joaoarquimedes/hifiaudio_project/docs/subbass/esquema.png

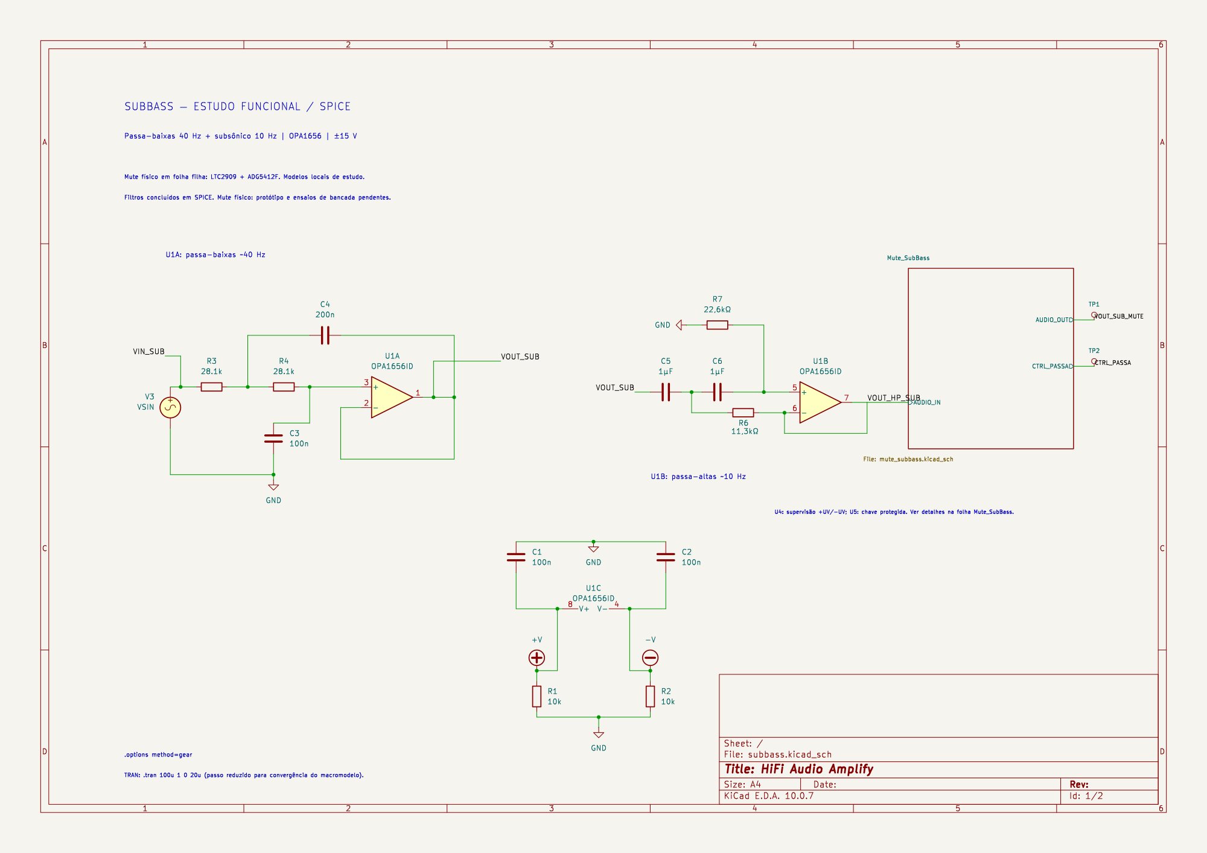
docs/subbass/esquema.png
