joaoarquimedes/hifiaudio_project/docs/subbass/falhas_trilhos.png

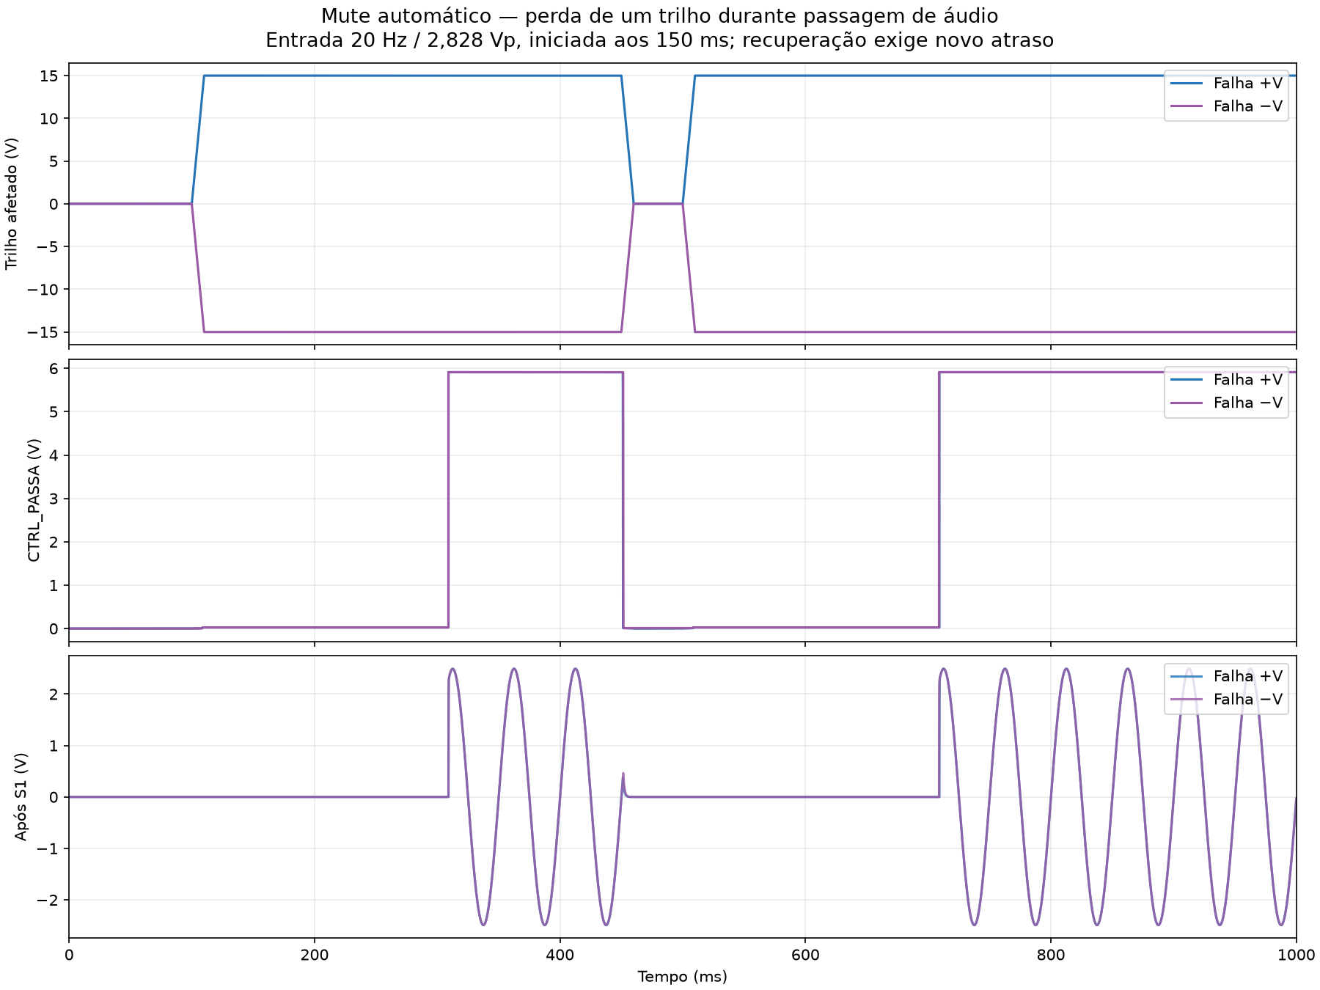
docs/subbass/falhas_trilhos.png
