joaoarquimedes/hifiaudio_project/docs/subbass/hardware/esquema_mute.png

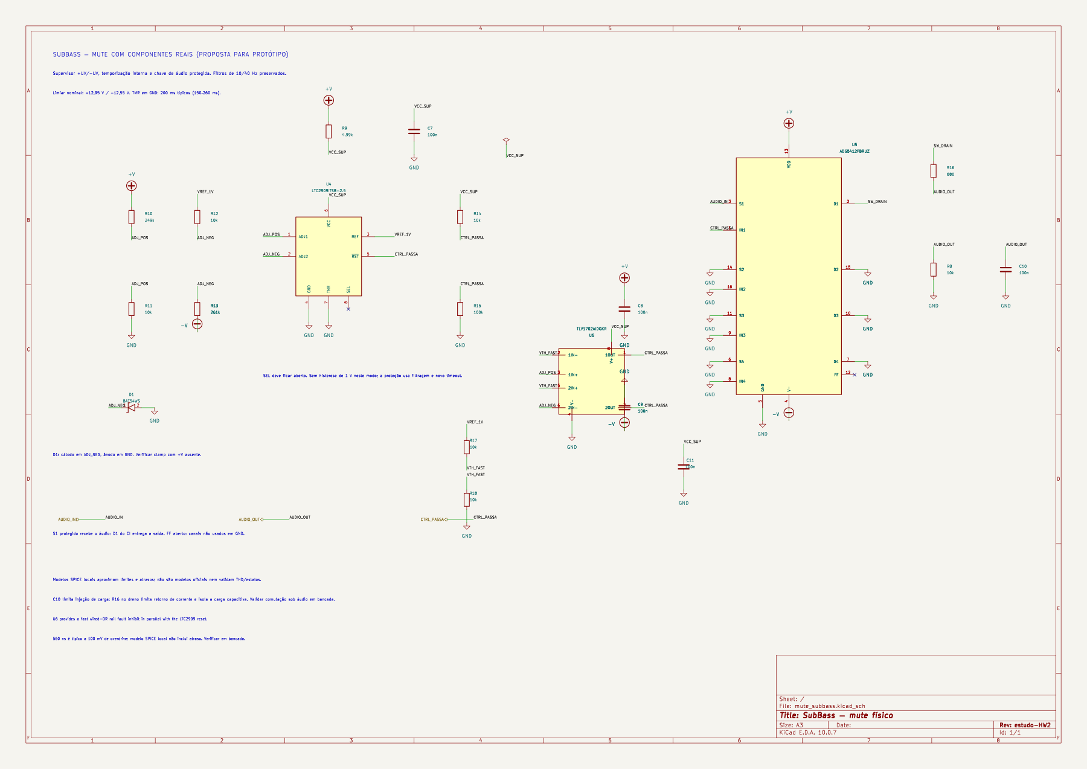
docs/subbass/hardware/esquema_mute.png
