joaoarquimedes/hifiaudio_project/docs/subbass/mute_automatico.png

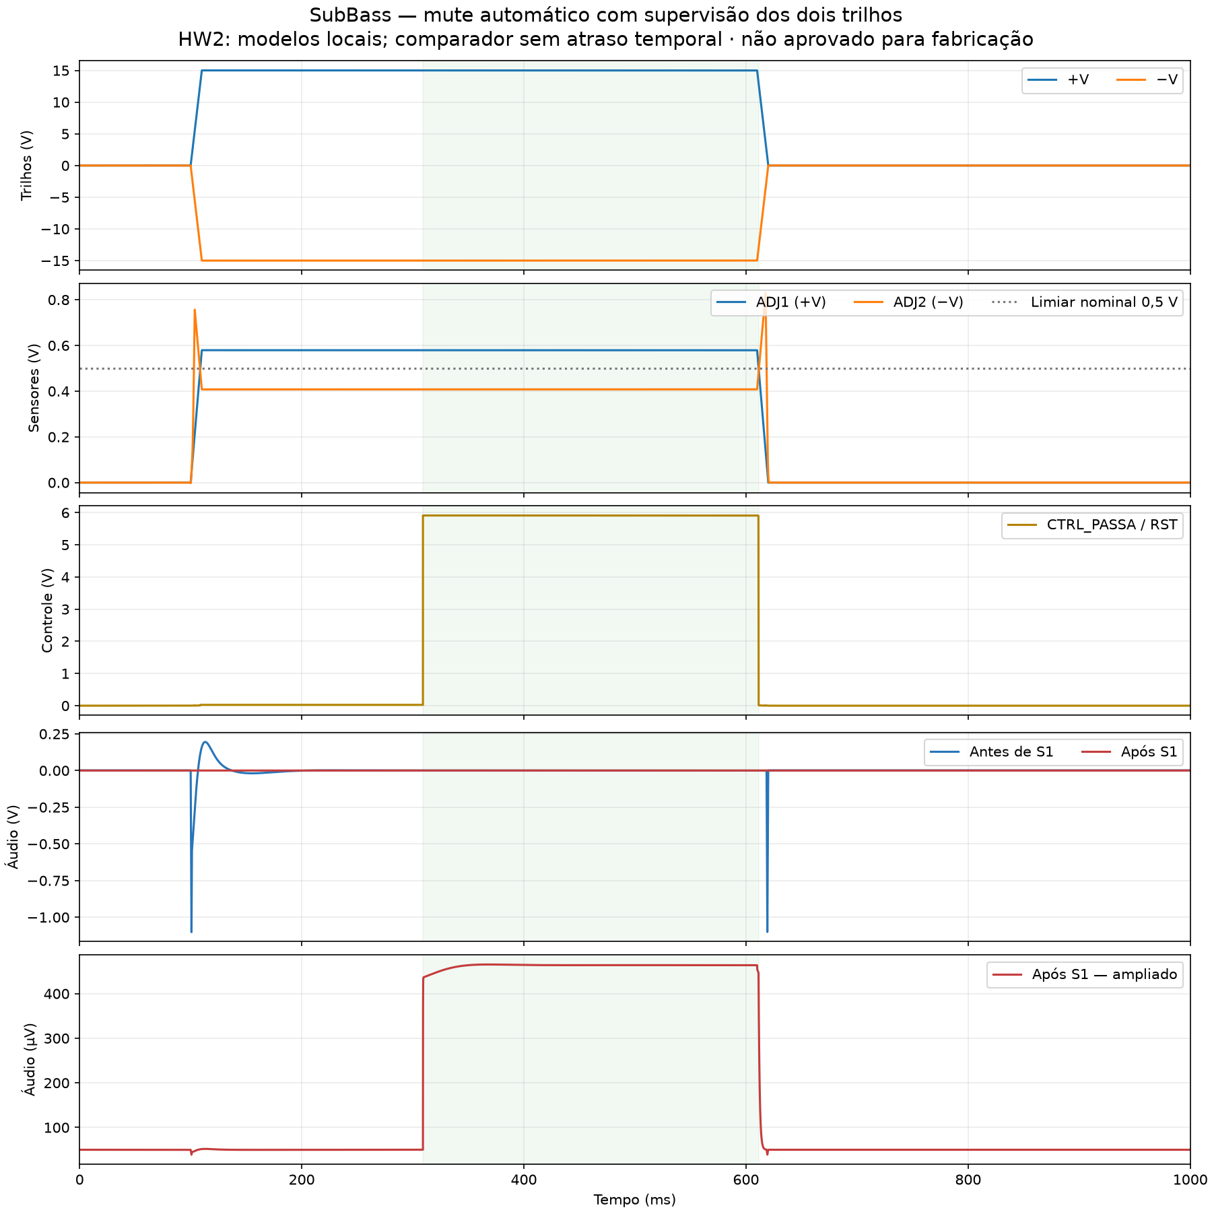
docs/subbass/mute_automatico.png
