joaoarquimedes/hifiaudio_project/docs/subbass/resposta_ac.png

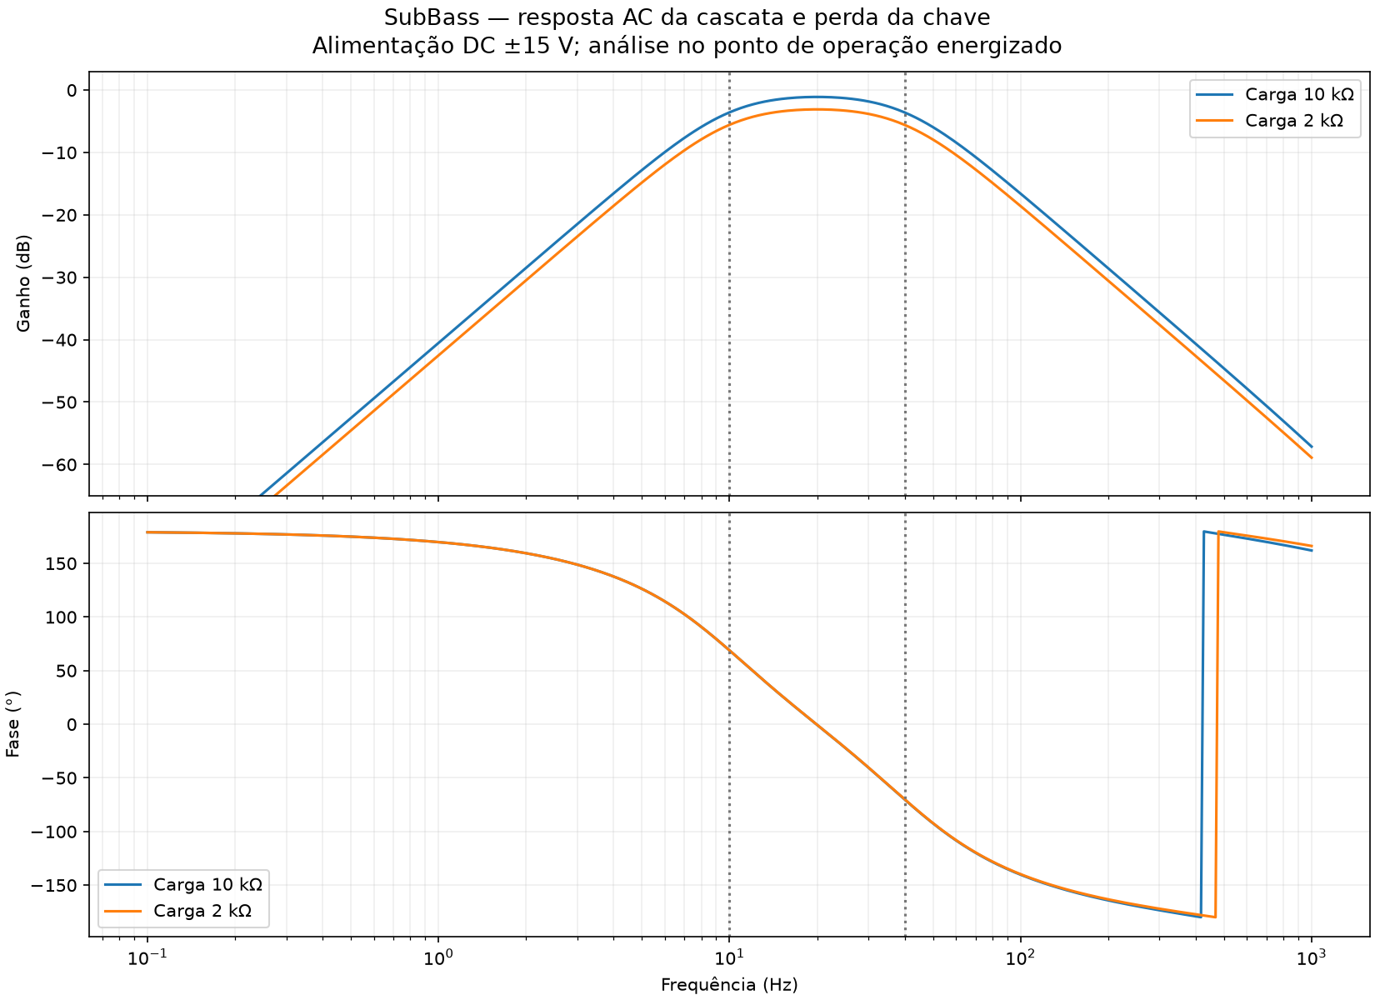
docs/subbass/resposta_ac.png
