joaoarquimedes/hifiaudio_project/(list of files, drawings)

Other design files:
spice/OPA1656/sbomaw6c/OPA1656.OLB
spice/OPA1656/sbomaw6c/OPA1656_Test_Circuit.DSN
spice/OPA1656/sbomaw6c/OPA1656_Test_Circuit.OPJ
