joaoarquimedes/hifiaudio_project/hifi_audio.kicad_pcb

## KiCad design hifi_audio.kicad_pcb (2026-10-16)

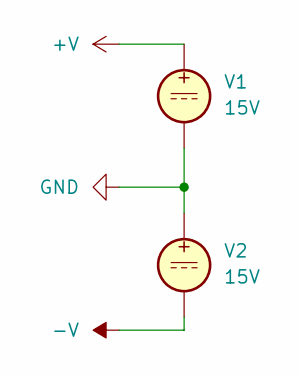
[picture p6: schematic Bancada_Simulacao.kicad_sch, HiFi Audio Amplify]

Parts:
V1, V2: 15V

Connections:
unnamed: V1.2, V2.1

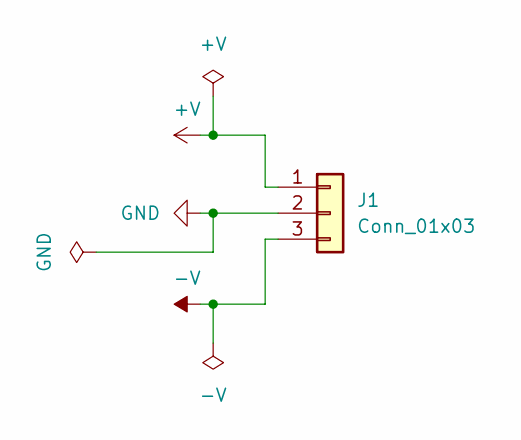
[picture p7: schematic fonte_alimentacao.kicad_sch, HiFi Audio Amplify]

Parts:
J1: Conn_01x03; JST_XH_B3B-XH-A_1x03_P2.50mm_Vertical

Connections:
+V: J1.1; also elsewhere on the board
-V: J1.3; also elsewhere on the board
GND: J1.2; also elsewhere on the board

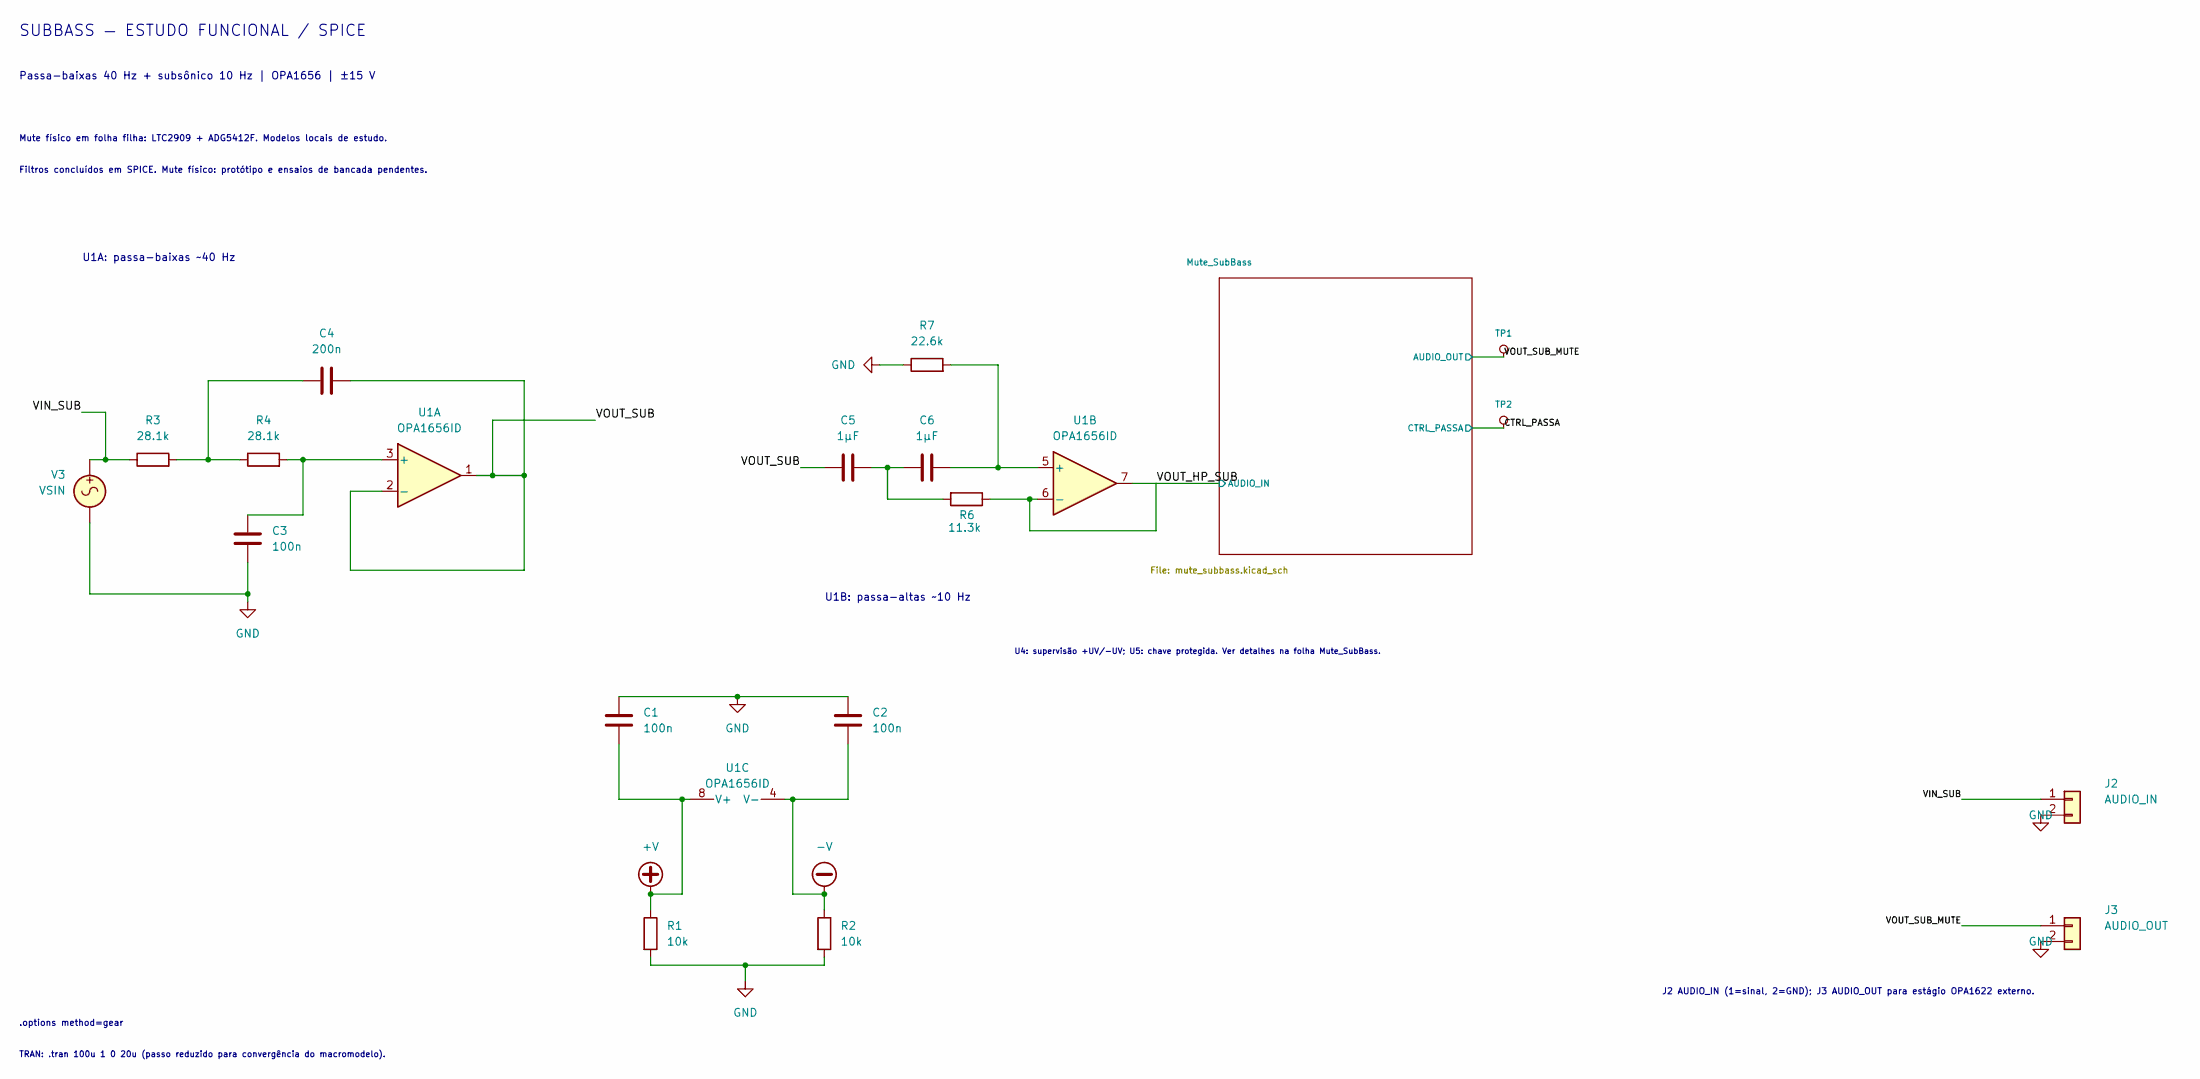
[picture p8: schematic subbass.kicad_sch, HiFi Audio Amplify]

Parts:
C1, C2, C3: 100n; C_0805_2012Metric
C4: 200n; C_0805_2012Metric
C5, C6: 1µF; C_1206_3216Metric
J2: AUDIO_IN; JST_XH_B2B-XH-A_1x02_P2.50mm_Vertical
J3: AUDIO_OUT; JST_XH_B2B-XH-A_1x02_P2.50mm_Vertical
R1, R2: 10k; R_0805_2012Metric
R3, R4: 28.1k; R_0805_2012Metric
R6: 11.3k; R_0805_2012Metric
R7: 22.6k; R_0805_2012Metric
TP1, TP2: TestPoint; TestPoint_Pad_D1.5mm
U1: OPA1656ID; SOIC-8_3.9x4.9mm_P1.27mm
V3: VSIN

Connections:
+V: C1.2, R1.1, U1.8 (V+); also elsewhere on the board
-V: C2.2, R2.1, U1.4 (V-); also elsewhere on the board
/subbass/CTRL_PASSA: TP2.1; also elsewhere on the board
/subbass/VIN_SUB: J2.1, R3.1, V3.1
/subbass/VOUT_HP_SUB: R6.1, U1.6 (-), U1.7; also elsewhere on the board
/subbass/VOUT_SUB: C4.2, C5.1, U1.1, U1.2 (-)
/subbass/VOUT_SUB_MUTE: J3.1, TP1.1; also elsewhere on the board
GND: C1.1, C2.1, C3.2, J2.2, J3.2, R1.2, R2.2, R7.1, V3.2; also elsewhere on the board
unnamed: C4.1, R3.2, R4.1
unnamed: C5.2, C6.1, R6.2
unnamed: C3.1, R4.2, U1.3 (+)
unnamed: C6.2, R7.2, U1.5 (+)

Notes on the sheet:
SUBBASS — ESTUDO FUNCIONAL / SPICE
Passa-baixas 40 Hz + subsônico 10 Hz | OPA1656 | ±15 V
U1A: passa-baixas ~40 Hz
U1B: passa-altas ~10 Hz
.options method=gear
TRAN: .tran 100u 1 0 20u (passo reduzido para convergência do macromodelo).
Mute físico em folha filha: LTC2909 + ADG5412F. Modelos locais de estudo.
Filtros concluídos em SPICE. Mute físico: protótipo e ensaios de bancada pendentes.
U4: supervisão +UV/-UV; U5: chave protegida. Ver detalhes na folha Mute_SubBass.
J2 AUDIO_IN (1=sinal, 2=GND); J3 AUDIO_OUT para estágio OPA1622 externo.

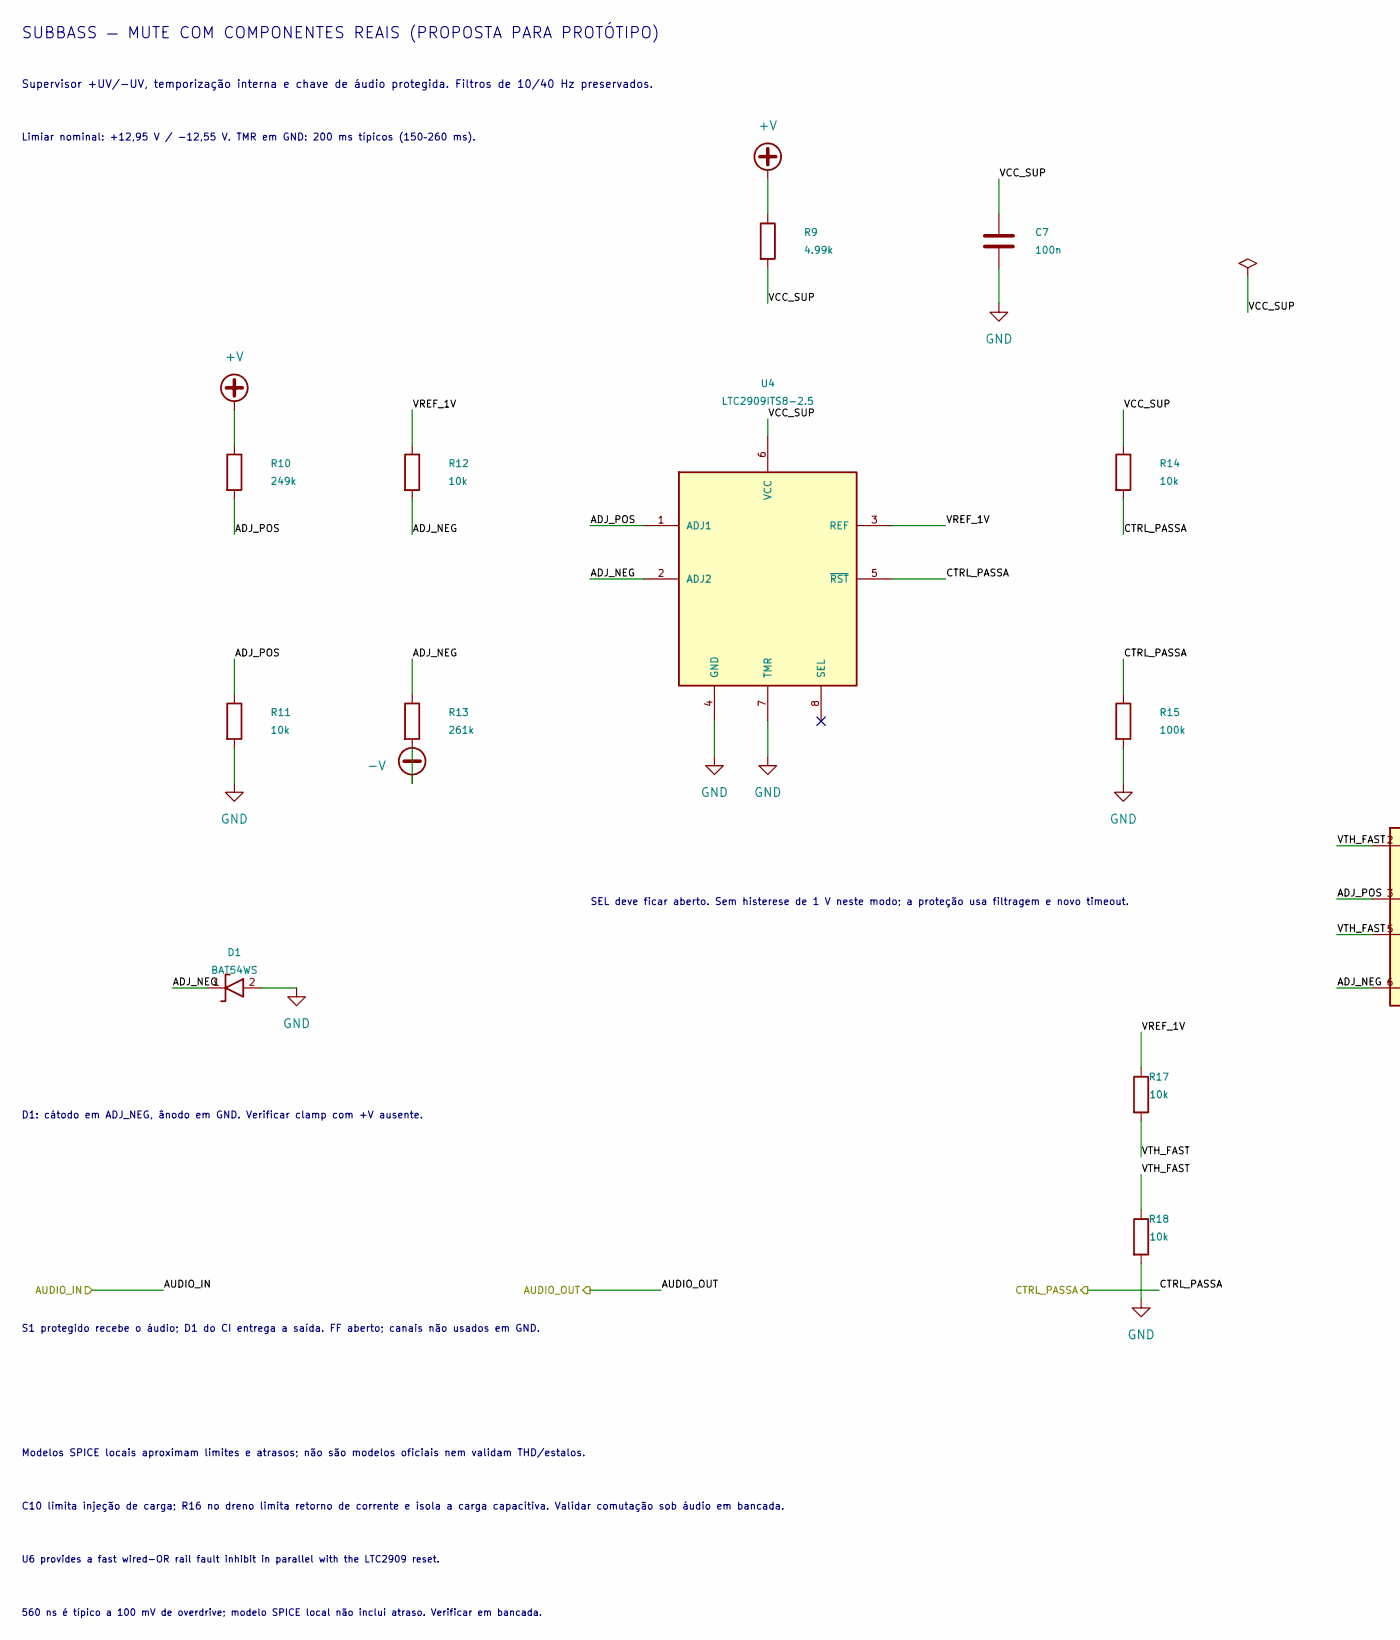
[picture p9: schematic mute_subbass.kicad_sch, SubBass — mute físico, part in row 1, column 1]

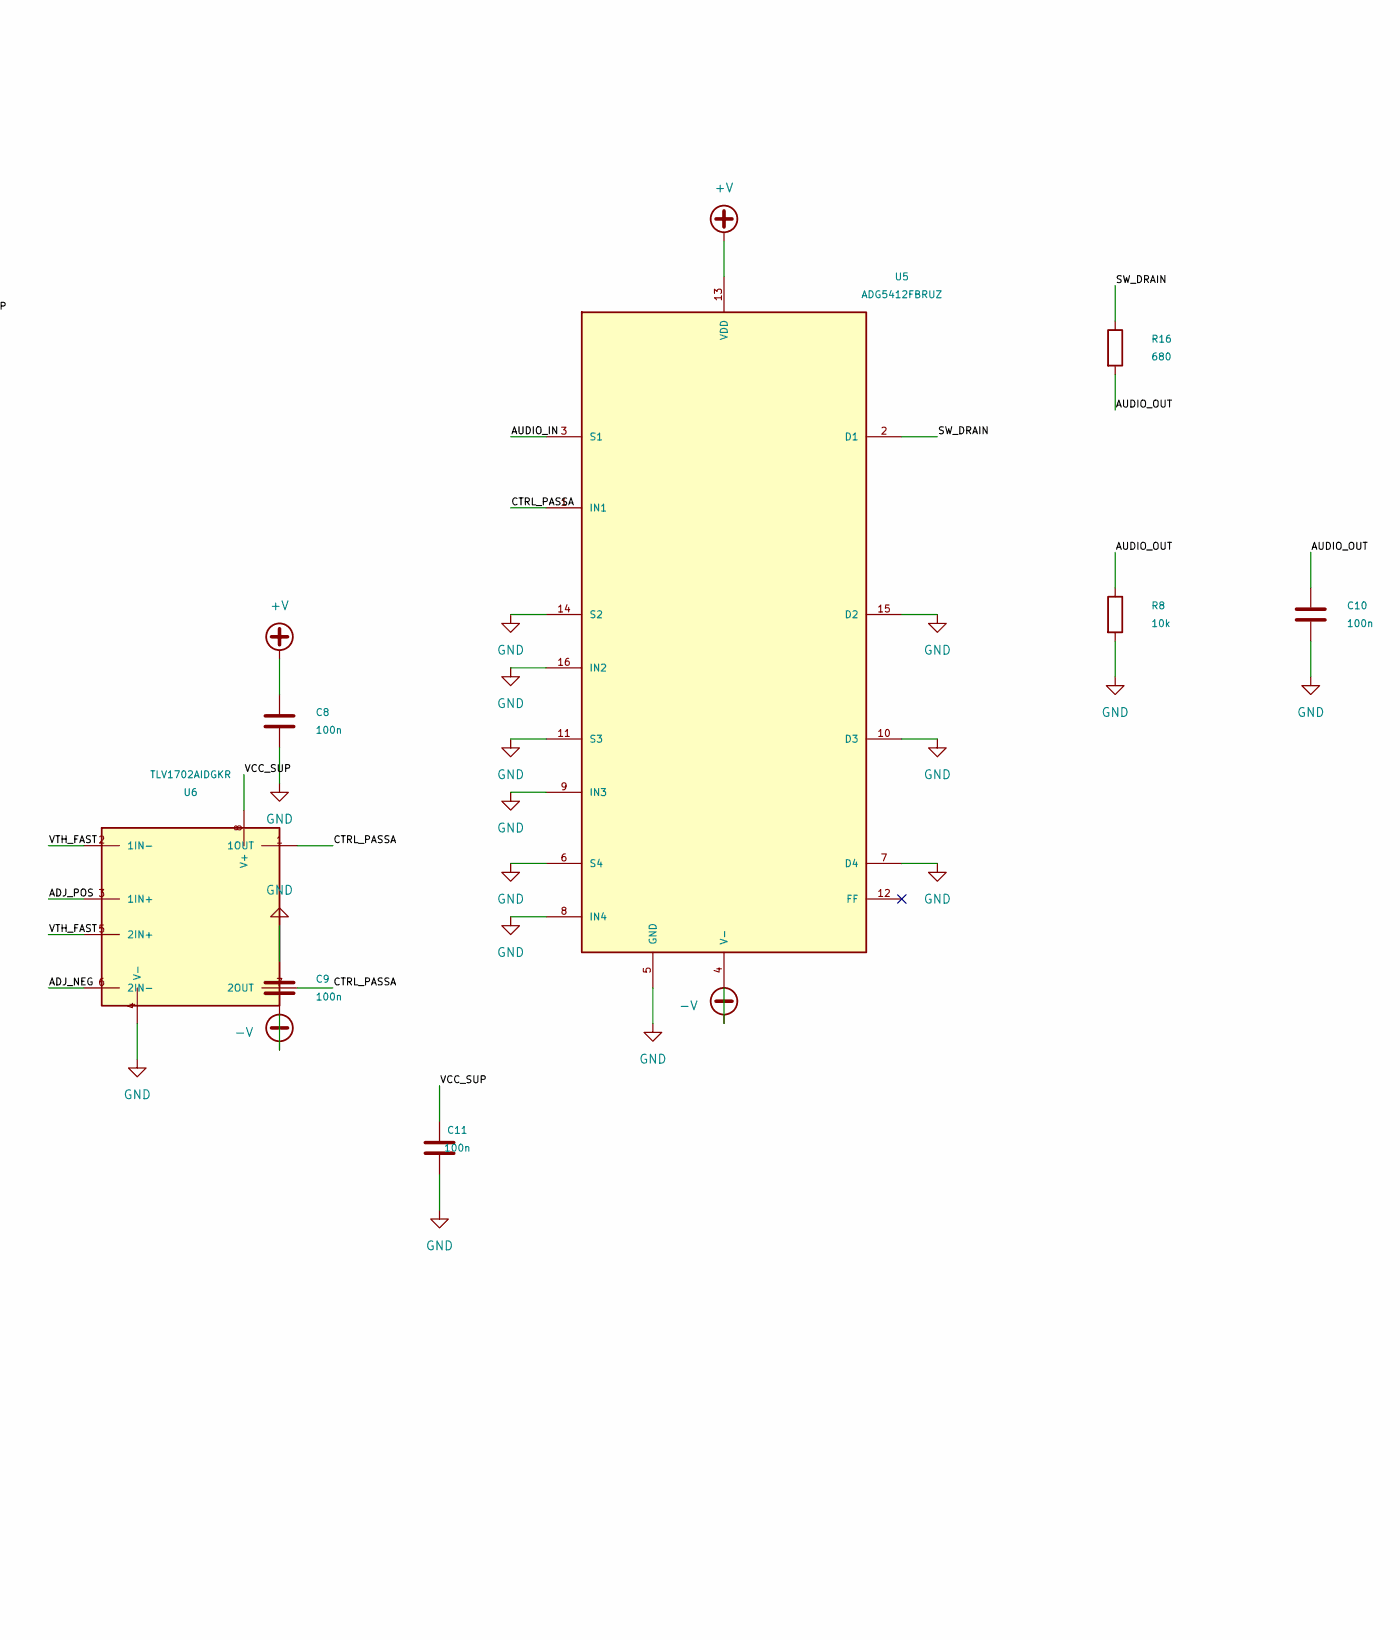
[picture p10: schematic mute_subbass.kicad_sch, SubBass — mute físico, part in row 1, column 2]

Parts:
C7, C8, C9: 100n; C_0805_2012Metric; Voltage 50V; Tolerance 10%
C10: 100n; C_1206_3216Metric; Voltage 50V; Tolerance 5%
C11: 100n; C_0805_2012Metric; Voltage 50V; MPN GRM21BR71H104KA01L
D1: BAT54WS; D_SOD-323; MPN BAT54WS-7-F
R8, R14: 10k; R_0805_2012Metric; Tolerance 1%
R9: 4.99k; R_0805_2012Metric; Tolerance 0.1%
R10: 249k; R_0805_2012Metric; Tolerance 0.1%
R11, R12: 10k; R_0805_2012Metric; Tolerance 0.1%
R13: 261k; R_0805_2012Metric; Tolerance 0.1%
R15: 100k; R_0805_2012Metric; Tolerance 1%
R16: 680; R_1206_3216Metric; Tolerance 1%
R17, R18: 10k; R_0805_2012Metric; Tolerance 1%; MPN CRCW080510K0FKEA
U4: LTC2909ITS8-2.5; SOT-23-8; MPN LTC2909ITS8-2.5#TRMPBF
U5: ADG5412FBRUZ; TSSOP-16_4.4x5mm_P0.65mm; MPN ADG5412FBRUZ
U6: TLV1702AIDGKR; VSSOP-8_2.3x2mm_P0.5mm; MPN TLV1702AIDGKR

Connections:
+V: C8.1, R9.1, R10.1, U5.13 (VDD); also elsewhere on the board
-V: C9.2, R13.2, U5.4 (V-); also elsewhere on the board
/subbass/CTRL_PASSA: R14.2, R15.1, U4.5 (~RST), U5.1 (IN1), U6.1 (1OUT), U6.7 (2OUT); also elsewhere on the board
/subbass/Mute_SubBass/ADJ_NEG: D1.1 (K), R12.2, R13.1, U4.2 (ADJ2), U6.6 (2IN-)
/subbass/Mute_SubBass/ADJ_POS: R10.2, R11.1, U4.1 (ADJ1), U6.3 (1IN+)
/subbass/Mute_SubBass/SW_DRAIN: R16.1, U5.2 (D1)
/subbass/Mute_SubBass/VCC_SUP: C7.1, C11.1, R9.2, R14.1, U4.6 (VCC), U6.8 (V+)
/subbass/Mute_SubBass/VREF_1V: R12.1, R17.1, U4.3 (REF)
/subbass/Mute_SubBass/VTH_FAST: R17.2, R18.1, U6.2 (1IN-), U6.5 (2IN+)
/subbass/VOUT_HP_SUB: U5.3 (S1); also elsewhere on the board
/subbass/VOUT_SUB_MUTE: C10.1, R8.1, R16.2; also elsewhere on the board
GND: C7.2, C8.2, C9.1, C10.2, C11.2, D1.2 (A), R8.2, R11.2, R15.2, R18.2, U4.4 (GND), U4.7 (TMR), U5.5 (GND), U5.6 (S4), U5.7 (D4), U5.8 (IN4), U5.9 (IN3), U5.10 (D3), U5.11 (S3), U5.14 (S2), U5.15 (D2), U5.16 (IN2), U6.4 (V-); also elsewhere on the board

Notes on the sheet:
SUBBASS — MUTE COM COMPONENTES REAIS (PROPOSTA PARA PROTÓTIPO)
Supervisor +UV/-UV, temporização interna e chave de áudio protegida. Filtros de 10/40 Hz preservados.
Limiar nominal: +12,95 V / −12,55 V. TMR em GND: 200 ms típicos (150–260 ms).
SEL deve ficar aberto. Sem histerese de 1 V neste modo; a proteção usa filtragem e novo timeout.
D1: cátodo em ADJ_NEG, ânodo em GND. Verificar clamp com +V ausente.
S1 protegido recebe o áudio; D1 do CI entrega a saída. FF aberto; canais não usados em GND.
Modelos SPICE locais aproximam limites e atrasos; não são modelos oficiais nem validam THD/estalos.
C10 limita injeção de carga; R16 no dreno limita retorno de corrente e isola a carga capacitiva. Validar comutação sob áudio em bancada.
U6 provides a fast wired-OR rail fault inhibit in parallel with the LTC2909 reset.
560 ns é típico a 100 mV de overdrive; modelo SPICE local não inclui atraso. Verificar em bancada.

Board: 2 copper layers, 42 parts (0 on the bottom side), 18 nets, no tracks yet.

Other parts of the board:
MH1, MH2, MH3, MH4: MountingHole_3.2mm_M3
