joaoarquimedes/hifiaudio_project/(commit log)

2026-10-15 Definicao subbass e filtro passa baixo
    [Bancada_Simulacao.kicad_sch, fonte_alimentacao.kicad_sch, hifi_audio.kicad_sch, subbass.kicad_sch]
2026-10-15 preparando fase subsonica
    [subbass.kicad_sch]
2026-10-16 Valida cascata subbass 40 Hz e subsonico 10 Hz em ±15 V
    [Bancada_Simulacao.kicad_sch, fonte_alimentacao.kicad_sch, subbass.kicad_sch]
2026-10-16 Conclui ensaios de degrau e sequenciamento da alimentacao do subbass
    [Bancada_Simulacao.kicad_sch, subbass.kicad_sch]
2026-10-16 Add SubBass mute control and verification scripts
    - Introduced a new SPICE subcircuit for SubBass mute control, implementing a dual-rail supervisor with diagnostic outputs.
    - Created a symbol library for Hi-Fi audio components in KiCad.
    - Added a Python script to plot results from SubBass simulations, visualizing startup, shutdown, and AC response.
    - Developed a verification script for the SubBass design, exporting netlists and validating functionality through simulation with ngspice.
    [Bancada_Simulacao.kicad_sch, subbass.kicad_sch]
2026-10-16 Finalize SubBass mute hardware proposal
    [bom_mute.csv, mute_subbass.kicad_sch, subbass.kicad_sch]
2026-10-16 Refactor SubBass hardware and verification scripts for HW2 mute proposal
    - Added TLV1702 fast fault path model to subbass_hardware.lib for improved fault detection.
    - Updated plot_subbass.py title and descriptions to reflect changes in hardware proposal from HW1 to HW2.
    - Modified verify_subbass.py to validate the new HW2 mute proposal, including adjustments to expected cutoff timing and report details.
    - Enhanced test cases for fault detection and recovery scenarios to ensure robustness with new hardware configurations.
    [bom_mute.csv, mute_subbass.kicad_sch]
2026-10-16 Refactor SubBass project: Update track widths, add new connector symbols, and document modular architecture
    - Reduced minimum track width and clearance in hifi_audio.kicad_pro for improved routing.
    - Added new connector symbols for AUDIO_IN and AUDIO_OUT in subsbass.kicad_sch.
    - Updated footprints for various components in subsbass.kicad_sch to ensure compatibility.
    - Introduced modular architecture documentation in arquitetura_modular.md outlining the design and electrical interfaces.
    - Created build_subbass_module_board.py script to automate PCB placement from schematic netlist.
    [fonte_alimentacao.kicad_sch, hifi_audio.kicad_pcb, subbass.kicad_sch]
2026-10-16 Update hifi_audio.kicad_pro: Add diff pair dimensions, track widths, and via dimensions
2026-10-16 Ajustes e limpeza
    [mute_subbass.kicad_sch, subbass.kicad_sch]
